JLipina/Kids_Mission_Control_Panel/Pictures/20230906_010632.jpg

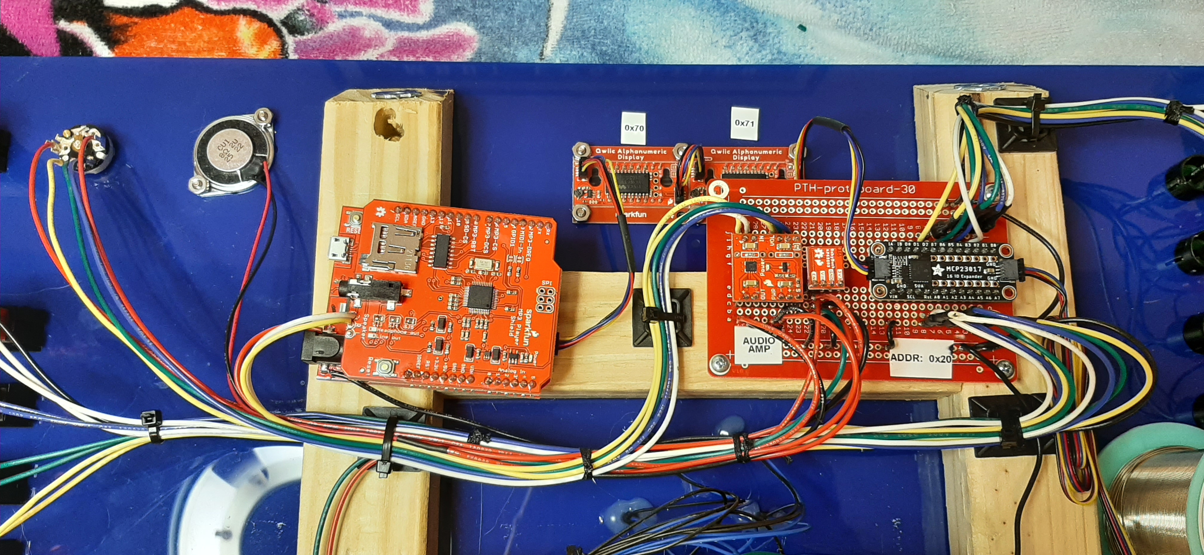
Pictures/20230906_010632.jpg
