JLipina/Kids_Mission_Control_Panel/Design Docs/Mission Control Panel Concept V1.PNG

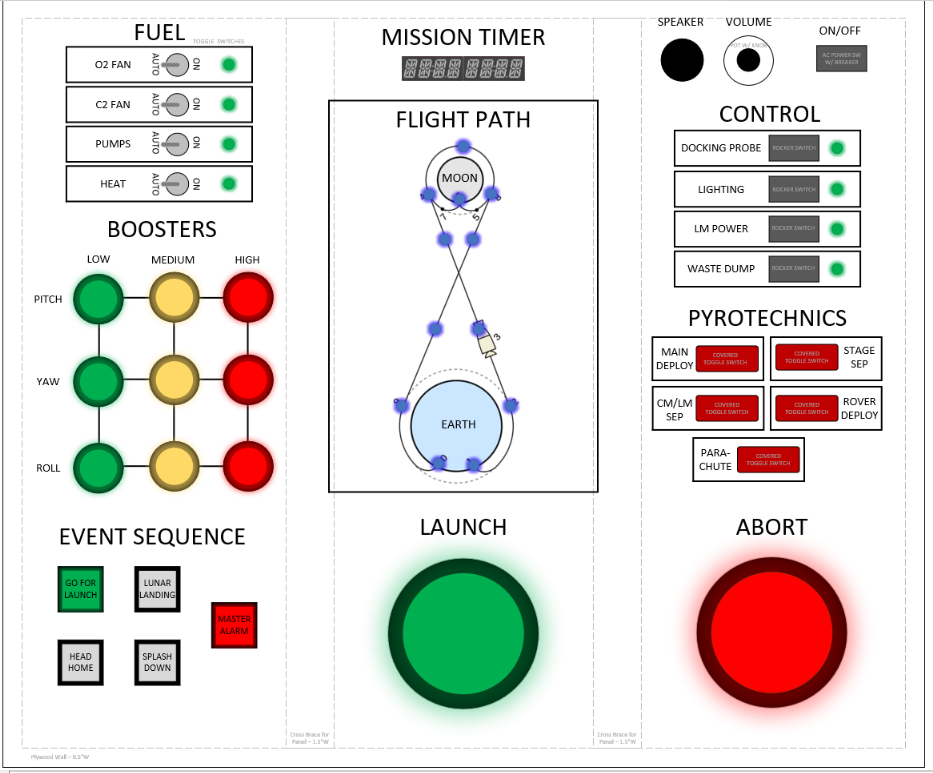
Design Docs/Mission Control Panel Concept V1.PNG
