JLipina/Kids_Mission_Control_Panel/Pictures/20230906_010615.jpg

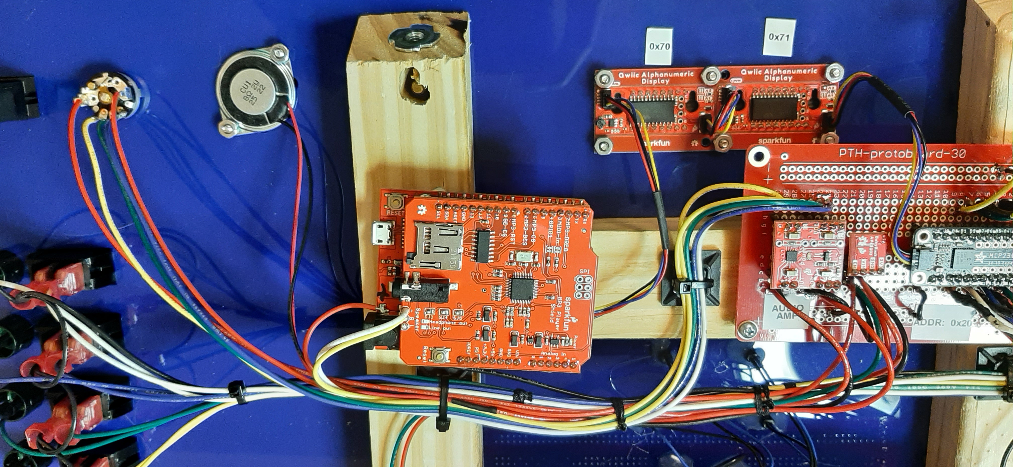
Pictures/20230906_010615.jpg
