JLipina/Kids_Mission_Control_Panel/Pictures/20230906_230627.jpg

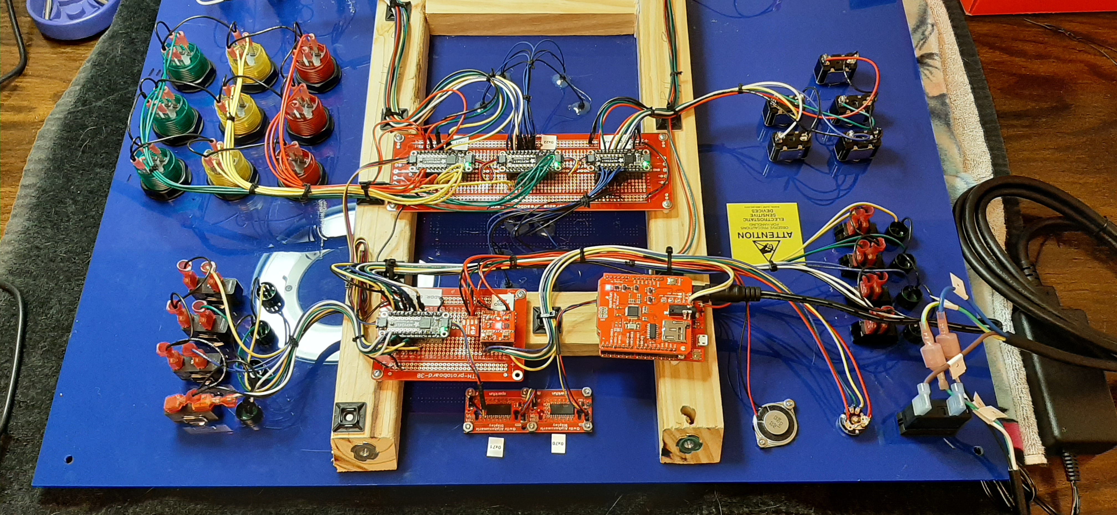
Pictures/20230906_230627.jpg
