JLipina/Kids_Mission_Control_Panel/Pictures/20230906_230656.jpg

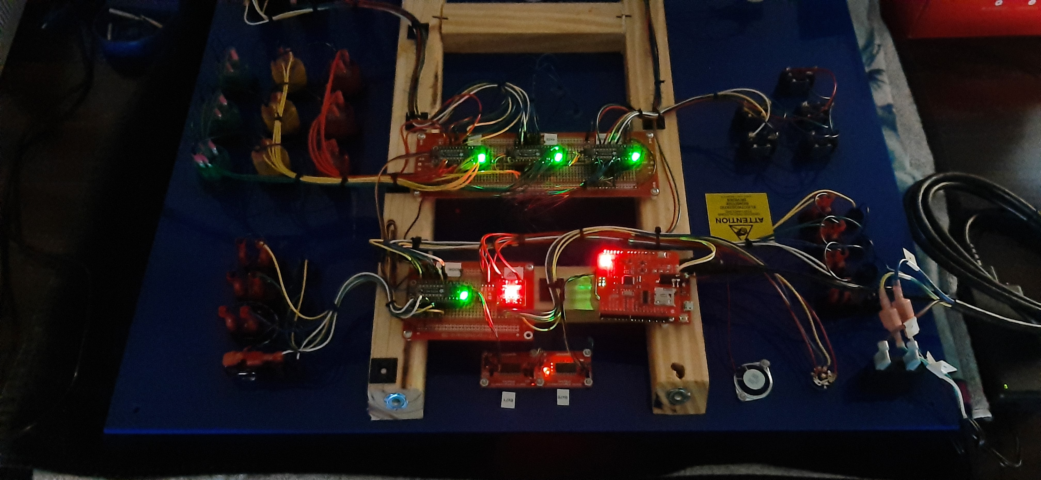
Pictures/20230906_230656.jpg
