JLipina/Kids_Mission_Control_Panel/Design Docs/Panel_BOM_6-10-23.xlsx

Description | MFG PN | Vendor PN | Vendor | QTY | Unit Cost | Line Total | Link | Notes
CORD 18AWG NEMA 5-15P TO CBL 6' | 211011-01 | Q941-ND | Digikey | 1 | $5.34 | $5.34 | https://www.digikey.com/en/products/detail/qualtek/211011-01/5639882 | AC wall plug to wires
Circular - 0.625" (15.88mm) Bushing 0.440" (11.18mm) Black | 2077 | 3720-2077-ND | Digikey | 10 | $0.11 | $1.12 | https://www.digikey.com/en/products/detail/heyco-products-corporation/2077/15906780 | For AC Cable passthough
TA36 CIRCUIT BREAKER 1P RO 5A | 3-128-200 | 486-3-128-200-ND | Digikey | 1 | $14.28 | $14.28 | https://www.digikey.com/en/products/detail/schurter-inc/3-128-200/14835864 | AC Power Switch with Breaker
CRD 18AWG IEC320-C13 - CBL 6.56' | 315005-01 | Q945-ND | Digikey | 1 | $6.51 | $6.51 | https://www.digikey.com/en/products/detail/qualtek/315005-01/1466536 | Internal AC switch to AC DC Converter Input
AC/DC DESKTOP ADAPTER 12V 36W | SDI36-12-U-P5 | 102-5154-ND | Digikey | 1 | $18.30 | $18.30 | https://www.digikey.com/en/products/detail/cui-inc/SDI36-12-U-P5/9817243 | AC DC converter for Arduino
SparkFun BabyBuck Regulator Breakout - 3.3V (AP63203) | COM-18357 | COM-18357 | Sparkfun | 1 | $4.50 | $4.50 | https://www.sparkfun.com/products/18357 | 3.3V Converter
SparkFun RedBoard Qwiic | DEV-15123 | DEV-15123 | Sparkfun | 1 | $21.50 | $21.50 | https://www.sparkfun.com/products/15123 | Microcontroller
SparkFun MP3 Player Shield | DEV-12660 | DEV-12660 | Sparkfun | 1 | $28.95 | $28.95 | https://www.sparkfun.com/products/12660 | Sound board
CONN HEADER VERT 20POS 2.54MM | 10129378-920001BLF | 10129378-920001BLF-ND | Digikey | 15 | $0.37 | $5.59 | https://www.digikey.com/en/products/detail/amphenol-cs-fci/10129378-920001BLF/7915969 | single row 0.1" Pitch Headers male
CONN HDR 13POS 0.1 TIN PCB | PPTC131LFBN-RC | S7011-ND | Digikey | 15 | $0.72 | $10.75 | https://www.digikey.com/en/products/detail/sullins-connector-solutions/PPTC131LFBN-RC/810151 | single row 0.1" Pitch Headers female
TPA2005D1 AUDIO AMP MONO 1.4W | BOB-11044 | 1568-1025-ND | Digikey | 1 | $9.50 | $9.50 | https://www.digikey.com/en/products/detail/sparkfun-electronics/BOB-11044/5140790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 | Speaker Amp
SPEAKER 8OHM 2W TOP PORT 99DB | CMS-28528N-L152 | 102-3841-ND | Digikey | 2 | $3.70 | $7.40 | https://www.digikey.com/en/products/detail/cui-devices/CMS-28528N-L152/6137734 | Speaker
microSD Card - 1GB (Class 4) | COM-15107 | COM-15107 | Sparkfun | 1 | $5.50 | $5.50 | https://www.sparkfun.com/products/15107 | microSD card
POT 10K OHM 1/20W PLASTIC LOG | P170SP1-FC15AR10K | 987-1739-ND | Digikey | 1 | $2.47 | $2.47 | https://www.digikey.com/en/products/detail/tt-electronics-bi/P170SP1-FC15AR10K/5957483 | Volume control pot
KNOB SMOOTH 0.236" PLASTIC | 1506 | 1722-1254-ND | Digikey | 2 | $3.23 | $6.46 | https://www.digikey.com/en/products/detail/davies-molding-llc/1506/6566477 | Volume Knob
Hook-Up Wire - Assortment (Stranded, 22 AWG) | PRT-11375 | PRT-11375 | Sparkfun | 1 | $22.50 | $22.50 | https://www.sparkfun.com/products/11375 | 22 awg wire kit
SparkFun Qwiic Alphanumeric Display - Red | COM-16916 | COM-16916 | Sparkfun | 2 | $9.95 | $19.90 | https://www.sparkfun.com/products/16916 | 7 seg display
STEMMA QT MCP23017 GPIO EXPAND | 5346 | 1528-5346-ND | Digikey | 4 | $5.95 | $23.80 | https://www.digikey.com/en/products/detail/adafruit-industries-llc/5346/15913270 | IO expanders
Qwiic Boost | SPX-17238 | SPX-17238 | Sparkfun | 1 | $3.95 | $3.95 | https://www.sparkfun.com/products/17238 | Qwiic level converter
Qwiic Cable - 50mm | PRT-14426 | PRT-14426 | Sparkfun | 4 | $0.95 | $3.80 | https://www.sparkfun.com/products/14426 | Qwiic Cable (50mm)
Qwiic Cable - 100mm | PRT-14427 | PRT-14427 | Sparkfun | 2 | $1.50 | $3.00 | https://www.sparkfun.com/products/14427 | Qwiic Cable (100mm)
Qwiic Cable - 500mm | PRT-14429 | PRT-14429 | Sparkfun | 1 | $1.95 | $1.95 | https://www.sparkfun.com/products/14429 | Qwiic Cable (500mm)
Qwiic JST Connector - SMD 4-Pin (Vertical) | PRT-16766 | PRT-16766 | Sparkfun | 7 | $0.55 | $3.85 | https://www.sparkfun.com/products/16766 | Qwiic Conn Vertical
SparkFun Solder-able Breadboard - Large | PRT-12699 | PRT-12699 | Sparkfun | 1 | $9.95 | $9.95 | https://www.sparkfun.com/products/12699 | proto soldering board large
SparkFun Solder-able Breadboard | PRT-12070 | PRT-12070 | Sparkfun | 3 | $5.50 | $16.50 | https://www.sparkfun.com/products/12070 | proto soldering board small
Big Dome Pushbutton - Green | COM-11275 | COM-11275 | Sparkfun | 1 | $12.95 | $12.95 | https://www.sparkfun.com/products/11275 | Green launch button
Big Dome Pushbutton - Red | COM-09181 | COM-09181 | Sparkfun | 1 | $12.95 | $12.95 | https://www.sparkfun.com/products/9181 | Red abort button
uxcell Game Push Button 34x34 Square 12V LED Illuminated Push Button Switch with Micro Switch for Arcade Video Games White 5pcs | ‎A19062000ux0446 | B07WQS69FQ | Amazon | 1 | $12.99 | $12.99 | https://www.amazon.com/dp/B07WQS69FQ/?coliid=INY0QTRAYR1CQ&colid=214XN6MOHGY0B | Square pushbutton set (5 buttons)
LED RED DIFFUSED 5MM ROUND T/H | MT4118-HR-A | 1125-1188-ND | Digikey | 15 | $0.19 | $2.83 | https://www.digikey.com/en/products/detail/marktech-optoelectronics/MT4118-HR-A/4214622 | square pushbutton LEDs (5mm red) | 5
LED GREEN DIFFUSED T-1 3/4 T/H | LTL-307G | LTL-307G | Digikey | 15 | $0.19 | $2.90 | https://www.digikey.com/en/products/detail/liteon/LTL-307G/669998 | square pushbutton LEDs (5mm green) | 8
SWITCH PUSH SPST-NO GRN 10MA 5V | 3487 | 1528-2321-ND | Digikey | 3 | $2.50 | $7.50 | https://www.digikey.com/en/products/detail/adafruit-industries-llc/3487/7364334 | Round arcade button (Green)
SWITCH PUSH SPST-NO YEL 10MA 5V | 3488 | 1528-2420-ND | Digikey | 3 | $2.50 | $7.50 | https://www.digikey.com/en/products/detail/adafruit-industries-llc/3488/7794999 | Round arcade button (Yellow)
SWITCH PUSH SPST-NO RED 10MA 5V | 3489 | 1528-2316-ND | Digikey | 3 | $2.50 | $7.50 | https://www.digikey.com/en/products/detail/adafruit-industries-llc/3489/7349495 | Round arcade button (Red)
CONN QC RCPT 18-22AWG 0.110 | 190190004 | WM18259-ND | Digikey | 45 | $0.23 | $10.35 | https://www.digikey.com/en/products/detail/molex/0190190004/279060 | Arcade button quick connects | 36
Nilight 90014E Heavy Duty Rocker Toggle Switch 12V 20A Red Cover SPST ON/Off 2Pin Car Truck Boat-5 Pack | 90014E | B07QKFD7Z7 | Amazon | 1 | $8.66 | $8.66 | https://www.amazon.com/dp/B07QKFD7Z7/?coliid=I2W1JWJY1F4WJ6&colid=214XN6MOHGY0B | Pyrotechnic toggle switches with covers set (5 switches)
Toggle Switch SPST Panel Mount | C3900BAAAA | 708-3058-ND | Digikey | 6 | $2.83 | $16.98 | https://www.digikey.com/en/products/detail/bulgin/C3900BAAAA/9598414 | Toggle switch (2pos)
SWITCH ROCKER SPST 16A 125V | GRS-2011-2015 | CWI456-ND | Digikey | 4 | $0.65 | $2.60 | https://www.digikey.com/en/products/detail/cw-industries/GRS-2011-2015/4425741 | Rocker switch (2pos)
CONN QC RCPT 18-22AWG 0.250 | 2-520263-2 | A27821CT-ND | Digikey | 30 | $0.32 | $9.63 | https://www.digikey.com/en/products/detail/te-connectivity-amp-connectors/2-520263-2/289251 | Rocker Switch, AC PWR SW, toggle switch, Quick Connects | 18
LED PANEL IND BLUE SNAP-IN 6" | 12-00003 | 839-12-00003-ND | Digikey | 15 | $1.94 | $29.14 | https://www.digikey.com/en/products/detail/tensility-international-corp/12-00003/17840391 | Small flush LED (FLIGHT PATH section) | 12
LED GREEN DIFFUSED 10MM T/H | WP813GD | 754-1898-ND | Digikey | 15 | $0.28 | $4.22 | https://www.digikey.com/en/products/detail/kingbright/WP813GD/3084264 | Large LEDs (10mm) | 8
LED HOLDER FOR 10MM LEDS | COM-11841 | 1568-1623-ND | Digikey | 10 | $0.55 | $5.50 | https://www.digikey.com/en/products/detail/sparkfun-electronics/COM-11841/7319613 | 10mm LED Holder (FUEL & CONTROL sections) | 8
RES 10K OHM 1% 1/4W AXIAL | RNF14FTD10K0 | RNF14FTD10K0CT-ND | Digikey | 100 | $0.04 | $3.54 | https://www.digikey.com/en/products/detail/stackpole-electronics-inc/RNF14FTD10K0/1706596 | Misc res (Pull down/ups) 10k
RES 1K OHM 5% 1/4W AXIAL | CF14JT1K00 | CF14JT1K00CT-ND | Digikey | 100 | $0.02 | $2.26 | https://www.digikey.com/en/products/detail/stackpole-electronics-inc/CF14JT1K00/1741314 | Misc res 1k
RES 120 OHM 5% 1/4W AXIAL | CF14JT120R | CF14JT120RCT-ND | Digikey | 100 | $0.02 | $2.26 | https://www.digikey.com/en/products/detail/stackpole-electronics-inc/CF14JT120R/1741278 | 5mm/10mm LED curr lim res
RES 30 OHM 5% 1/4W AXIAL | CF14JT30R0 | CF14JT30R0CT-ND | Digikey | 100 | $0.02 | $2.26 | https://www.digikey.com/en/products/detail/stackpole-electronics-inc/CF14JT30R0/1741389 | Flight path LED curr lim res
CBL TIE LOCKING BLK 18LBS 4.06" | 1-604771-0 | A112495-ND | Digikey | 50 | $0.13 | $6.42 | https://www.digikey.com/en/products/detail/te-connectivity-raychem-cable-protection/1-604771-0/2343016 | small zip ties
30 Sheets 8.5 x 11 Inch Clear Transparency Film 100% Transparent Sheets for Inkjet Printers Silk Screen Printing Overhead Projector Film | Clear Transparency Film | B08X2N82SX | Amazon | 1 | $6.99 | $6.99 | https://www.amazon.com/Transparency-Printers-Printing-Overhead-Projector/dp/B08X2N82SX | Transparency Film for Button Labels
ROUND SPACER #4 NYLON 1/4" | 9908-250 | 492-1074-ND | Digikey | 25 | $0.04 | $1.07 | https://www.digikey.com/en/products/detail/bivar-inc/9908-250/586394 | Board Spacer 0.25"
 |  |  |  |  |  | $0.00
 |  |  |  |  |  | $0.00
 |  |  |  |  |  | $0.00
 |  |  |  |  |  | $0.00
 |  |  |  |  |  | $0.00
 |  |  |  |  |  | $0.00
 |  | Total Estimated Cost |  |  |  | $310.03
NOTES: - Diagram of Flight Path for panel found at: https://en.wikipedia.org/wiki/Lunar_orbit_rendezvous - Much inspiration from Jeff Highsmith's build: https://makezine.com/article/home/furniture/making-fun-mission-control-desk/ - Another person's recreation: http://missioncontroldesk.blogspot.com/search?updated-max=2015-11-04T03:31:00-08:00&max-results=7 Digikey Cart: https://www.digikey.com/en/mylists/list/CSTQRVFLY5 Amazon Cart: https://www.amazon.com/hz/wishlist/ls/214XN6MOHGY0B?ref_=wl_share Sparkfun Cart: http://sfe.io/w171814
