JLipina/Kids_Mission_Control_Panel/Kids_Mission_Control_Panel.ino

/*
 * 
 */

#include <SPI.h>
#include <FreeStack.h>
#include <Adafruit_MCP23X17.h>

//Add the SdFat Libraries
#include <SdFat.h>

//and the MP3 Shield Library
#include <vs1053_SdFat.h>

/**
 * \brief Object instancing the SdFat library.
 *
 * principal object for handling all SdCard functions.
 */
SdFat sd;

/**
 * \brief Object instancing the vs1053 library.
 *
 * principal object for handling all the attributes, members and functions for the library.
 */
vs1053 MP3player;

const uint8_t VOLUME =  0; //0x0000 is maximum volume or 0db attenuation. Total silence is 0xFEFE

#include <Wire.h>
#include <SparkFun_Alphanumeric_Display.h>  //Click here to get the library: http://librarymanager/All#SparkFun_Qwiic_Alphanumeric_Display by SparkFun
HT16K33 display;

/**
 * \brief Object instancing the MCP23X17 library.
 *
 * principal object for handling all the attributes, members and functions for the library.
 */
Adafruit_MCP23X17 mcp1;
Adafruit_MCP23X17 mcp2;
Adafruit_MCP23X17 mcp3;
Adafruit_MCP23X17 mcp4;

#define O2_FAN_LED              8
#define O2_FAN_SW               9
#define C2_FAN_LED              10
#define C2_FAN_SW               11
#define PUMPS_LED               12
#define PUMPS_SW                13
#define HEAT_LED                14
#define HEAT_SW                 15
bool O2_FAN_Played =            FALSE;
bool C2_FAN_Played =            FALSE;
bool PUMPS_Played =             FALSE;
bool HEAT_Played =              FALSE;

#define DOCKING_LED             0
#define DOCKING_SW              1
#define LIGHTING_LED            2
#define LIGHTING_SW             3
#define LM_POWER_LED            4
#define LM_POWER_SW             5
#define WASTE_DUMP_LED          6
#define WASTE_DUMP_SW           7
bool DOCKING_Played =           FALSE;
bool LIGHTING_Played =          FALSE;
bool LM_POWER_Played =          FALSE;
bool WASTE_DUMP_Played =        FALSE;

#define PYRO_MAIN_SW            1
#define PYRO_STAGE_SW           0
#define PYRO_CM_LM_SW           3
#define PYRO_ROVER_SW           2
#define PYRO_PARACHUTE_SW       4
bool PYRO_MAIN_Played =         FALSE;
bool PYRO_STAGE_Played =        FALSE;
bool PYRO_CM_LM_Played =        FALSE;
bool PYRO_ROVER_Played =    FALSE;
bool PYRO_PARACHUTE_Played =    FALSE;

#define BOOSTER_LOW_PITCH_LED     14
#define BOOSTER_LOW_PITCH_SW      15
#define BOOSTER_LOW_YAW_LED       12
#define BOOSTER_LOW_YAW_SW        13
#define BOOSTER_LOW_ROLL_LED      10
#define BOOSTER_LOW_ROLL_SW       11
#define BOOSTER_MED_PITCH_LED     8
#define BOOSTER_MED_PITCH_SW      9
#define BOOSTER_MED_YAW_LED       14
#define BOOSTER_MED_YAW_SW        15
#define BOOSTER_MED_ROLL_LED      12
#define BOOSTER_MED_ROLL_SW       13
#define BOOSTER_HIGH_PITCH_LED    10
#define BOOSTER_HIGH_PITCH_SW     11
#define BOOSTER_HIGH_YAW_LED      8
#define BOOSTER_HIGH_YAW_SW       9
#define BOOSTER_HIGH_ROLL_LED     6
#define BOOSTER_HIGH_ROLL_SW      7
bool BOOSTER_LOW_PITCH_Played =   FALSE;
bool BOOSTER_LOW_YAW_Played =     FALSE;
bool BOOSTER_LOW_ROLL_Played =    FALSE;
bool BOOSTER_MED_PITCH_Played =   FALSE;
bool BOOSTER_MED_YAW_Played =     FALSE;
bool BOOSTER_MED_ROLL_Played =    FALSE;
bool BOOSTER_HIGH_PITCH_Played =  FALSE;
bool BOOSTER_HIGH_YAW_Played =    FALSE;
bool BOOSTER_HIGH_ROLL_Played =   FALSE;

#define GO_FOR_LAUNCH_LED         4
#define GO_FOR_LAUNCH_SW          5
#define LUNAR_LANDING_LED         6
#define LUNAR_LANDING_SW          7
#define HEAD_HOME_LED             0
#define HEAD_HOME_SW              1
#define SPLASHDOWN_LED            2
#define SPLASHDOWN_SW             3
#define MASTER_ALARM_LED          4
#define MASTER_ALARM_SW           5
#define GO_FOR_LAUNCH_LED_SPEED   300
unsigned long launchLedBlinkStart;
unsigned long launchLedBlinkCurr;
bool GO_LAUNCH_LED_State =        1;
bool GO_FOR_LAUNCH_Played =       FALSE;
bool LUNAR_LANDING_Played =       FALSE;
bool HEAD_HOME_Played =           FALSE;
bool SPLASHDOWN_Played =          FALSE;
bool MASTER_ALARM_Played =        FALSE;

#define LAUNCH_SW               5
#define ABORT_SW                6
bool LAUNCH_Played =            FALSE;
bool ABORT_Played =             FALSE;

#define PATH_LED_1              3
#define PATH_LED_2              2
#define PATH_LED_3              15
#define PATH_LED_4              10
#define PATH_LED_5              9
#define PATH_LED_6              8
#define PATH_LED_7              12
#define PATH_LED_8              13
#define PATH_LED_9              14
#define PATH_LED_10             11
#define PATH_LED_11             0
#define PATH_LED_12             1
#define PATH_SPEED              2000
int pathPosition =              1;
bool changePosition =           FALSE;

unsigned long startMillis;
unsigned long currentMillis;
unsigned long timerMillis;
uint8_t numTensMilliseconds = 0;
uint8_t numSingleSeconds = 0;
uint8_t numTensSeconds = 0;
uint8_t numSingleMinutes = 0;
uint8_t numTensMinutes = 0;
uint8_t numSingleHours = 0;
uint8_t numTensHours = 0;
char digit[10] = "0123456789";
char time[12] = "00:0000:00";

//------------------------------------------------------------------------------
/**
 * \brief Setup the Arduino Chip's feature for our use.
 *
 * After Arduino's kernel has booted initialize basic features for this
 * application, such as Serial port and MP3player objects with .begin.
 * Along with displaying the Help Menu.
 *
 * \note returned Error codes are typically passed up from MP3player.
 * Whicn in turns creates and initializes the SdCard objects.
 *
 * \see
 * \ref Error_Codes
 */
void setup() {

  uint8_t result; //result code from some function as to be tested at later time.

  Serial.begin(115200);

  Serial.print(F("F_CPU = "));
  Serial.println(F_CPU);
  Serial.print(F("Free RAM = ")); // available in Version 1.0 F() bases the string to into Flash, to use less SRAM.
  Serial.print(FreeStack(), DEC);  // FreeStack() is provided by SdFat
  Serial.println(F(" Should be a base line of 1028, on ATmega328 when using INTx"));

  //Initialize the SdCard.
  if(!sd.begin(SD_SEL, SPI_FULL_SPEED)) sd.initErrorHalt();
  // depending upon your SdCard environment, SPI_HAVE_SPEED may work better.
  if(!sd.chdir("/")) sd.errorHalt("sd.chdir");

  //Initialize the MP3 Player Shield
  result = MP3player.begin();
  //check result, see readme for error codes.
  if(result != 0) {
    Serial.print(F("Error code: "));
    Serial.print(result);
    Serial.println(F(" when trying to start MP3 player"));
    if( result == 6 ) {
      Serial.println(F("Warning: patch file not found, skipping.")); // can be removed for space, if needed.
      Serial.println(F("Use the \"d\" command to verify SdCard can be read")); // can be removed for space, if needed.
    }
  }

  MP3player.setVolume(VOLUME); //Set panel volume once since there's no method of adjusting in software while in normal use.

  Wire.begin(); //Display joins I2C bus
  display.begin(0x71, 0x70);
  //display.print("DYNETICS");
  display.colonOn();
  display.print(time);

  mcp1.begin_I2C(0X20);
  mcp2.begin_I2C(0X21);
  mcp3.begin_I2C(0X22);
  mcp4.begin_I2C(0X23);

// FUEL SWITCH/LED SETUPS
  mcp1.pinMode(O2_FAN_LED, OUTPUT);
  mcp1.pinMode(O2_FAN_SW, INPUT_PULLUP);
  mcp1.pinMode(C2_FAN_LED, OUTPUT);
  mcp1.pinMode(C2_FAN_SW, INPUT_PULLUP);
  mcp1.pinMode(PUMPS_LED, OUTPUT);
  mcp1.pinMode(PUMPS_SW, INPUT_PULLUP);
  mcp1.pinMode(HEAT_LED, OUTPUT);
  mcp1.pinMode(HEAT_SW, INPUT_PULLUP);
  mcp1.digitalWrite(O2_FAN_LED, LOW);
  mcp1.digitalWrite(C2_FAN_LED, LOW);
  mcp1.digitalWrite(PUMPS_LED, LOW);
  mcp1.digitalWrite(HEAT_LED, LOW);

// CONTROL SWITCH/LED SETUPS
  mcp1.pinMode(DOCKING_LED, OUTPUT);
  mcp1.pinMode(DOCKING_SW, INPUT_PULLUP);
  mcp1.pinMode(LIGHTING_LED, OUTPUT);
  mcp1.pinMode(LIGHTING_SW, INPUT_PULLUP);
  mcp1.pinMode(LM_POWER_LED, OUTPUT);
  mcp1.pinMode(LM_POWER_SW, INPUT_PULLUP);
  mcp1.pinMode(WASTE_DUMP_LED, OUTPUT);
  mcp1.pinMode(WASTE_DUMP_SW, INPUT_PULLUP);
  mcp1.digitalWrite(DOCKING_LED, LOW);
  mcp1.digitalWrite(LIGHTING_LED, LOW);
  mcp1.digitalWrite(LM_POWER_LED, LOW);
  mcp1.digitalWrite(WASTE_DUMP_LED, LOW);

// PYRO SWITCH SETUPS
  mcp4.pinMode(PYRO_MAIN_SW, INPUT_PULLUP);
  mcp4.pinMode(PYRO_STAGE_SW, INPUT_PULLUP);
  mcp4.pinMode(PYRO_CM_LM_SW, INPUT_PULLUP);
  mcp4.pinMode(PYRO_ROVER_SW, INPUT_PULLUP);
  mcp4.pinMode(PYRO_PARACHUTE_SW, INPUT_PULLUP);

// EVENT SEQUENCE SETUP
  mcp3.pinMode(GO_FOR_LAUNCH_LED, OUTPUT);
  mcp3.pinMode(GO_FOR_LAUNCH_SW, INPUT_PULLUP);
  mcp3.pinMode(LUNAR_LANDING_LED, OUTPUT);
  mcp3.pinMode(LUNAR_LANDING_SW, INPUT_PULLUP);
  mcp2.pinMode(HEAD_HOME_LED, OUTPUT);
  mcp2.pinMode(HEAD_HOME_SW, INPUT_PULLUP);
  mcp2.pinMode(SPLASHDOWN_LED, OUTPUT);
  mcp2.pinMode(SPLASHDOWN_SW, INPUT_PULLUP);
  mcp2.pinMode(MASTER_ALARM_LED, OUTPUT);
  mcp2.pinMode(MASTER_ALARM_SW, INPUT_PULLUP);
  mcp3.digitalWrite(GO_FOR_LAUNCH_LED, HIGH);
  mcp3.digitalWrite(LUNAR_LANDING_LED, HIGH);
  mcp2.digitalWrite(HEAD_HOME_LED, HIGH);
  mcp2.digitalWrite(SPLASHDOWN_LED, HIGH);
  mcp2.digitalWrite(MASTER_ALARM_LED, LOW);

// LAUNCH & ABORT SWITCH SETUPS
  mcp4.pinMode(LAUNCH_SW, INPUT_PULLUP);
  mcp4.pinMode(ABORT_SW, INPUT_PULLUP);

// BOOSTER BUTTON/LED SETUPS
  mcp3.pinMode(BOOSTER_LOW_PITCH_LED, OUTPUT);
  mcp3.pinMode(BOOSTER_LOW_PITCH_SW, INPUT_PULLUP);
  mcp3.pinMode(BOOSTER_LOW_YAW_LED, OUTPUT);
  mcp3.pinMode(BOOSTER_LOW_YAW_SW, INPUT_PULLUP);
  mcp3.pinMode(BOOSTER_LOW_ROLL_LED, OUTPUT);
  mcp3.pinMode(BOOSTER_LOW_ROLL_SW, INPUT_PULLUP);
  mcp3.pinMode(BOOSTER_MED_PITCH_LED, OUTPUT);
  mcp3.pinMode(BOOSTER_MED_PITCH_SW, INPUT_PULLUP);
  mcp2.pinMode(BOOSTER_MED_YAW_LED, OUTPUT);
  mcp2.pinMode(BOOSTER_MED_YAW_SW, INPUT_PULLUP);
  mcp2.pinMode(BOOSTER_MED_ROLL_LED, OUTPUT);
  mcp2.pinMode(BOOSTER_MED_ROLL_SW, INPUT_PULLUP);
  mcp2.pinMode(BOOSTER_HIGH_PITCH_LED, OUTPUT);
  mcp2.pinMode(BOOSTER_HIGH_PITCH_SW, INPUT_PULLUP);
  mcp2.pinMode(BOOSTER_HIGH_YAW_LED, OUTPUT);
  mcp2.pinMode(BOOSTER_HIGH_YAW_SW, INPUT_PULLUP);
  mcp2.pinMode(BOOSTER_HIGH_ROLL_LED, OUTPUT);
  mcp2.pinMode(BOOSTER_HIGH_ROLL_SW, INPUT_PULLUP);
  mcp3.digitalWrite(BOOSTER_LOW_PITCH_LED, HIGH);
  mcp3.digitalWrite(BOOSTER_LOW_YAW_LED, HIGH);
  mcp3.digitalWrite(BOOSTER_LOW_ROLL_LED, HIGH);
  mcp3.digitalWrite(BOOSTER_MED_PITCH_LED, HIGH);
  mcp2.digitalWrite(BOOSTER_MED_YAW_LED, HIGH);
  mcp2.digitalWrite(BOOSTER_MED_ROLL_LED, HIGH);
  mcp2.digitalWrite(BOOSTER_HIGH_PITCH_LED, HIGH);
  mcp2.digitalWrite(BOOSTER_HIGH_YAW_LED, HIGH);
  mcp2.digitalWrite(BOOSTER_HIGH_ROLL_LED, HIGH);

// FLIGHT PATH LED SETUPS
  mcp3.pinMode(PATH_LED_1, OUTPUT);
  mcp3.pinMode(PATH_LED_2, OUTPUT);
  mcp4.pinMode(PATH_LED_3, OUTPUT);
  mcp4.pinMode(PATH_LED_4, OUTPUT);
  mcp4.pinMode(PATH_LED_5, OUTPUT);
  mcp4.pinMode(PATH_LED_6, OUTPUT);
  mcp4.pinMode(PATH_LED_7, OUTPUT);
  mcp4.pinMode(PATH_LED_8, OUTPUT);
  mcp4.pinMode(PATH_LED_9, OUTPUT);
  mcp4.pinMode(PATH_LED_10, OUTPUT);
  mcp3.pinMode(PATH_LED_11, OUTPUT);
  mcp3.pinMode(PATH_LED_12, OUTPUT);
  mcp3.digitalWrite(PATH_LED_1, HIGH);
  mcp3.digitalWrite(PATH_LED_2, LOW);
  mcp4.digitalWrite(PATH_LED_3, LOW);
  mcp4.digitalWrite(PATH_LED_4, LOW);
  mcp4.digitalWrite(PATH_LED_5, LOW);
  mcp4.digitalWrite(PATH_LED_6, LOW);
  mcp4.digitalWrite(PATH_LED_7, LOW);
  mcp4.digitalWrite(PATH_LED_8, LOW);
  mcp4.digitalWrite(PATH_LED_9, LOW);
  mcp4.digitalWrite(PATH_LED_10, LOW);
  mcp3.digitalWrite(PATH_LED_11, LOW);
  mcp3.digitalWrite(PATH_LED_12, LOW);

  startMillis = millis();
  launchLedBlinkStart = millis();
  timerMillis = millis();

}

//------------------------------------------------------------------------------

void loop() {

// FUEL SWITCHES ~~~~~~~~~~~~~~~~~~~~~~~~~~~~~~~~~~~~~~~~~~~~~~~~~~~~~~~~~~~~~~~~~~~~~~~~~~~~~~~~~~~~~~~~~~~~  

  O2_FAN_Played = checkSwitchMCP1NormallyOffLED(O2_FAN_SW, O2_FAN_LED, O2_FAN_Played, "o2_fan01.mp3");
  C2_FAN_Played = checkSwitchMCP1NormallyOffLED(C2_FAN_SW, C2_FAN_LED, C2_FAN_Played, "c2_fan01.mp3");
  PUMPS_Played = checkSwitchMCP1NormallyOffLED(PUMPS_SW, PUMPS_LED, PUMPS_Played, "pump0002.mp3");
  HEAT_Played = checkSwitchMCP1NormallyOffLED(HEAT_SW, HEAT_LED, HEAT_Played, "heat0001.mp3");

// CONTROL SWITCHES ~~~~~~~~~~~~~~~~~~~~~~~~~~~~~~~~~~~~~~~~~~~~~~~~~~~~~~~~~~~~~~~~~~~~~~~~~~~~~~~~~~~~~~~~~~~~ 

  DOCKING_Played = checkSwitchMCP1NormallyOffLED(DOCKING_SW, DOCKING_LED, DOCKING_Played, "dk_probe.mp3");
  LIGHTING_Played = checkSwitchMCP1NormallyOffLED(LIGHTING_SW, LIGHTING_LED, LIGHTING_Played, "lighting.mp3");
  LM_POWER_Played = checkSwitchMCP1NormallyOffLED(LM_POWER_SW, LM_POWER_LED, LM_POWER_Played, "lm_power.mp3");
  WASTE_DUMP_Played = checkSwitchMCP1NormallyOffLED(WASTE_DUMP_SW, WASTE_DUMP_LED, WASTE_DUMP_Played, "waste_dp.mp3");

// PYROTECHNIC SWITCHES ~~~~~~~~~~~~~~~~~~~~~~~~~~~~~~~~~~~~~~~~~~~~~~~~~~~~~~~~~~~~~~~~~~~~~~~~~~~~~~~~~~~~~~~~~~~~
  
  PYRO_MAIN_Played = checkSwitchNoLED(PYRO_MAIN_SW, PYRO_MAIN_Played, "main_dpy.mp3");
  PYRO_STAGE_Played = checkSwitchNoLED(PYRO_STAGE_SW, PYRO_STAGE_Played, "stag_sep.mp3");
  PYRO_CM_LM_Played = checkSwitchNoLED(PYRO_CM_LM_SW, PYRO_CM_LM_Played, "cmlm_sep.mp3");
  PYRO_ROVER_Played = checkSwitchNoLED(PYRO_ROVER_SW, PYRO_ROVER_Played, "rove_dpy.mp3");
  PYRO_PARACHUTE_Played = checkSwitchNoLED(PYRO_PARACHUTE_SW, PYRO_PARACHUTE_Played, "parachut.mp3");

// LAUNCH & ABORT BUTTONS ~~~~~~~~~~~~~~~~~~~~~~~~~~~~~~~~~~~~~~~~~~~~~~~~~~~~~~~~~~~~~~~~~~~~~~~~~~~~~~~~~~~~~~~~~~~~

  LAUNCH_Played = checkSwitchNoLED(LAUNCH_SW, LAUNCH_Played, "launch01.mp3");
  ABORT_Played = checkSwitchNoLED(ABORT_SW, ABORT_Played, "abort001.mp3");

// EVENT SEQUENCE BUTTONS ~~~~~~~~~~~~~~~~~~~~~~~~~~~~~~~~~~~~~~~~~~~~~~~~~~~~~~~~~~~~~~~~~~~~~~~~~~~~~~~~~~~~~~~~~~~~  

  GO_FOR_LAUNCH_Played = checkSwitchGoForLaunch(GO_FOR_LAUNCH_SW, GO_FOR_LAUNCH_LED, GO_FOR_LAUNCH_Played, "g4launch.mp3");
  LUNAR_LANDING_Played = checkSwitchMCP3NormallyOnLED(LUNAR_LANDING_SW, LUNAR_LANDING_LED, LUNAR_LANDING_Played, "lunaland.mp3");
  HEAD_HOME_Played = checkSwitchMCP2NormallyOnLED(HEAD_HOME_SW, HEAD_HOME_LED, HEAD_HOME_Played, "hed_home.mp3");
  SPLASHDOWN_Played = checkSwitchMCP2NormallyOnLED(SPLASHDOWN_SW, SPLASHDOWN_LED, SPLASHDOWN_Played, "spalshdn.mp3");
  MASTER_ALARM_Played = checkSwitchMCP2NormallyOffLED(MASTER_ALARM_SW, MASTER_ALARM_LED, MASTER_ALARM_Played, "mstr_alm.mp3");

// BOOSTER BUTTONS ~~~~~~~~~~~~~~~~~~~~~~~~~~~~~~~~~~~~~~~~~~~~~~~~~~~~~~~~~~~~~~~~~~~~~~~~~~~~~~~~~~~~~~~~~~~~

  BOOSTER_LOW_PITCH_Played = checkSwitchMCP3NormallyOnLED(BOOSTER_LOW_PITCH_SW, BOOSTER_LOW_PITCH_LED, BOOSTER_LOW_PITCH_Played, "bost_p_l.mp3");
  BOOSTER_LOW_YAW_Played = checkSwitchMCP3NormallyOnLED(BOOSTER_LOW_YAW_SW, BOOSTER_LOW_YAW_LED, BOOSTER_LOW_YAW_Played, "bost_y_l.mp3");
  BOOSTER_LOW_ROLL_Played = checkSwitchMCP3NormallyOnLED(BOOSTER_LOW_ROLL_SW, BOOSTER_LOW_ROLL_LED, BOOSTER_LOW_ROLL_Played, "bost_r_l.mp3");
  BOOSTER_MED_PITCH_Played = checkSwitchMCP3NormallyOnLED(BOOSTER_MED_PITCH_SW, BOOSTER_MED_PITCH_LED, BOOSTER_MED_PITCH_Played, "bost_p_m.mp3");
  BOOSTER_MED_YAW_Played = checkSwitchMCP2NormallyOnLED(BOOSTER_MED_YAW_SW, BOOSTER_MED_YAW_LED, BOOSTER_MED_YAW_Played, "bost_y_m.mp3");
  BOOSTER_MED_ROLL_Played = checkSwitchMCP2NormallyOnLED(BOOSTER_MED_ROLL_SW, BOOSTER_MED_ROLL_LED, BOOSTER_MED_ROLL_Played, "bost_r_m.mp3");
  BOOSTER_HIGH_PITCH_Played = checkSwitchMCP2NormallyOnLED(BOOSTER_HIGH_PITCH_SW, BOOSTER_HIGH_PITCH_LED, BOOSTER_HIGH_PITCH_Played, "bost_p_h.mp3");
  BOOSTER_HIGH_YAW_Played = checkSwitchMCP2NormallyOnLED(BOOSTER_HIGH_YAW_SW, BOOSTER_HIGH_YAW_LED, BOOSTER_HIGH_YAW_Played, "bost_y_h.mp3");
  BOOSTER_HIGH_ROLL_Played = checkSwitchMCP2NormallyOnLED(BOOSTER_HIGH_ROLL_SW, BOOSTER_HIGH_ROLL_LED, BOOSTER_HIGH_ROLL_Played, "bost_r_h.mp3");

// FLIGHT PATH LEDS ~~~~~~~~~~~~~~~~~~~~~~~~~~~~~~~~~~~~~~~~~~~~~~~~~~~~~~~~~~~~~~~~~~~~~~~~~


  currentMillis = millis();
  if(currentMillis - startMillis >= PATH_SPEED){
    changePosition = TRUE;
    pathPosition++;
    if(pathPosition >= 13){
      pathPosition = 1;
    }
    startMillis = millis();
  }

  if(changePosition == TRUE){
    if(pathPosition == 1){
      mcp3.digitalWrite(PATH_LED_12, LOW);
      mcp3.digitalWrite(PATH_LED_1, HIGH);
      changePosition = FALSE;
    }
    else if(pathPosition == 2){
      mcp3.digitalWrite(PATH_LED_1, LOW);
      mcp3.digitalWrite(PATH_LED_2, HIGH);
      changePosition = FALSE;
    }
    else if(pathPosition == 3){
      mcp3.digitalWrite(PATH_LED_2, LOW);
      mcp4.digitalWrite(PATH_LED_3, HIGH);
      changePosition = FALSE;
    }
    else if(pathPosition == 4){
      mcp4.digitalWrite(PATH_LED_3, LOW);
      mcp4.digitalWrite(PATH_LED_4, HIGH);
      changePosition = FALSE;
    }
    else if(pathPosition == 5){
      mcp4.digitalWrite(PATH_LED_4, LOW);
      mcp4.digitalWrite(PATH_LED_5, HIGH);
      changePosition = FALSE;
    }
    else if(pathPosition == 6){
      mcp4.digitalWrite(PATH_LED_5, LOW);
      mcp4.digitalWrite(PATH_LED_6, HIGH);
      changePosition = FALSE;
    }
    else if(pathPosition == 7){
      mcp4.digitalWrite(PATH_LED_6, LOW);
      mcp4.digitalWrite(PATH_LED_7, HIGH);
      changePosition = FALSE;
    }
    else if(pathPosition == 8){
      mcp4.digitalWrite(PATH_LED_7, LOW);
      mcp4.digitalWrite(PATH_LED_8, HIGH);
      changePosition = FALSE;
    }
    else if(pathPosition == 9){
      mcp4.digitalWrite(PATH_LED_8, LOW);
      mcp4.digitalWrite(PATH_LED_9, HIGH);
      changePosition = FALSE;
    }
    else if(pathPosition == 10){
      mcp4.digitalWrite(PATH_LED_9, LOW);
      mcp4.digitalWrite(PATH_LED_10, HIGH);
      changePosition = FALSE;
    }
    else if(pathPosition == 11){
      mcp4.digitalWrite(PATH_LED_10, LOW);
      mcp3.digitalWrite(PATH_LED_11, HIGH);
      changePosition = FALSE;
    }
    else if(pathPosition == 12){
      mcp3.digitalWrite(PATH_LED_11, LOW);
      mcp3.digitalWrite(PATH_LED_12, HIGH);
      changePosition = FALSE;
    }
  }
  
// Mission Control Timer ~~~~~~~~~~~~~~~~~~~~~~~~~~~~~~~~~~~~~~~~~~~~~~~~~~~~~~~~~~~~~~~~~~~~~~~~~~~~~~~~~~~~~~~~~~~~~~~~~~~~~~

  if(currentMillis - timerMillis >= 100){
    numTensMilliseconds ++;
    if(numTensMilliseconds >= 10){
      numTensMilliseconds = 0;
      numSingleSeconds ++;
      if(numSingleSeconds >= 10){
        numSingleSeconds = 0;
        numTensSeconds ++;
        if(numTensSeconds >= 7){
          numTensSeconds = 0;
          numSingleMinutes ++;
          if(numSingleMinutes >= 10){
            numSingleMinutes = 0;
            numTensMinutes ++;
            if(numTensMinutes >= 7){
              numTensMinutes = 0;
              numSingleHours ++;
              if(numSingleHours >= 10){
                numSingleHours = 0;
                numTensHours ++;
                if(numTensHours >= 10){
                  numTensHours = 0;
                }
                //display.printChar(digit[numTensHours], 0);
                time[0] = digit[numTensHours];
              }
              //display.printChar(digit[numSingleHours], 1);
              time[1] = digit[numSingleHours];
            }
            //display.printChar(digit[numTensMinutes], 2);
            time[3] = digit[numTensMinutes];
          }
          //display.printChar(digit[numSingleMinutes], 3);
          time[4] = digit[numSingleMinutes];
        }
        //display.printChar(digit[numTensSeconds], 4);
        time[5] = digit[numTensSeconds];
      }
      //display.printChar(digit[numSingleSeconds], 5);
      time[6] = digit[numSingleSeconds];
      //display.print(time);
    }
    timerMillis = millis();
    //display.printChar(digit[numTensMilliseconds], 6);
    time[8] = digit[numTensMilliseconds];
    display.print(time);
  }

}

// Functions ~~~~~~~~~~~~~~~~~~~~~~~~~~~~~~~~~~~~~~~~~~~~~~~~~~~~~~~~~~~~~~~~~~~~~~~~~~~~~~~~~~~~~~~~~~~~~~~~~~~~

bool checkSwitchMCP1NormallyOffLED(int switchName, int LEDName, bool playedState, char* audioFileName) {
  if(!mcp1.digitalRead(switchName) && playedState == FALSE){
    mcp1.digitalWrite(LEDName, HIGH);
    MP3player.playMP3(audioFileName);
    playedState = TRUE;
    Serial.print(audioFileName);
    Serial.println(F(" ON"));
  } 
  if(mcp1.digitalRead(switchName) && playedState == TRUE){
    mcp1.digitalWrite(LEDName, LOW);
    playedState = FALSE;
    Serial.print(audioFileName);
    Serial.println(F(" OFF"));
  }
  return playedState;
}

bool checkSwitchMCP2NormallyOffLED(int switchName, int LEDName, bool playedState, char* audioFileName) {
  if(!mcp2.digitalRead(switchName) && playedState == FALSE){
    mcp2.digitalWrite(LEDName, HIGH);
    MP3player.playMP3(audioFileName);
    playedState = TRUE;
    Serial.print(audioFileName);
    Serial.println(F(" ON"));
  } 
  if(mcp2.digitalRead(switchName) && playedState == TRUE){
    mcp2.digitalWrite(LEDName, LOW);
    playedState = FALSE;
    Serial.print(audioFileName);
    Serial.println(F(" OFF"));
  }
  return playedState;
}

bool checkSwitchMCP2NormallyOnLED(int switchName, int LEDName, bool playedState, char* audioFileName) {
  if(!mcp2.digitalRead(switchName) && playedState == FALSE){
    mcp2.digitalWrite(LEDName, LOW);
    MP3player.playMP3(audioFileName);
    playedState = TRUE;
    Serial.print(audioFileName);
    Serial.println(F(" ON"));
  } 
  if(mcp2.digitalRead(switchName) && playedState == TRUE){
    mcp2.digitalWrite(LEDName, HIGH);
    playedState = FALSE;
    Serial.print(audioFileName);
    Serial.println(F(" OFF"));
  }
  return playedState;
}

bool checkSwitchMCP3NormallyOnLED(int switchName, int LEDName, bool playedState, char* audioFileName) {
  if(!mcp3.digitalRead(switchName) && playedState == FALSE){
    mcp3.digitalWrite(LEDName, LOW);
    MP3player.playMP3(audioFileName);
    playedState = TRUE;
    Serial.print(audioFileName);
    Serial.println(F(" ON"));
  } 
  if(mcp3.digitalRead(switchName) && playedState == TRUE){
    mcp3.digitalWrite(LEDName, HIGH);
    playedState = FALSE;
    Serial.print(audioFileName);
    Serial.println(F(" OFF"));
  }
  return playedState;
}

bool checkSwitchNoLED(int switchName, bool playedState, char* audioFileName) {
  if(!mcp4.digitalRead(switchName) && playedState == FALSE){
    MP3player.playMP3(audioFileName);
    playedState = TRUE;
    Serial.print(audioFileName);
    Serial.println(F(" ON"));
  } 
  if(mcp4.digitalRead(switchName) && playedState == TRUE){
    playedState = FALSE;
    Serial.print(audioFileName);
    Serial.println(F(" OFF"));
  }
  return playedState;
}

bool checkSwitchGoForLaunch(int switchName, int LEDName, bool playedState, char* audioFileName) {
  if(!mcp3.digitalRead(switchName) && playedState == FALSE){
    MP3player.playMP3(audioFileName);
    playedState = TRUE;
    Serial.print(audioFileName);
    Serial.println(F(" ON"));
  } 
  if(mcp3.digitalRead(switchName) && playedState == TRUE){
    playedState = FALSE;
    Serial.print(audioFileName);
    Serial.println(F(" OFF"));
  }

  launchLedBlinkCurr = millis();
    if(launchLedBlinkCurr - launchLedBlinkStart >= GO_FOR_LAUNCH_LED_SPEED){
      GO_LAUNCH_LED_State = !GO_LAUNCH_LED_State;
      mcp3.digitalWrite(GO_FOR_LAUNCH_LED, GO_LAUNCH_LED_State);
      launchLedBlinkStart = millis();
    }
  return playedState;
}
