JLipina/Kids_Mission_Control_Panel/(commit log)

2023-10-14 Initial Document Upload
    Uploaded design files, a folder for audio files, pictures, and the minimally viable Arduino code.
    [Panel_BOM_6-10-23.xlsx]
2023-10-15 Completed Panel Functionality
    Changed ino name to match repo folder name; Changed audio file names to 8 character names as required by the mp3 player library; Adjusted and added new audio files for remaining switches; Put switch and LED control into functions and call those functions in loop() to make it easier to follow, update, and take up less storage; Added functionality for rest of panel, pyro, control, and launch/abort buttons.
2023-10-19 Adjusted Audio & Added Mission Timer
    Mission Time functionality added to count up the time since turn-on on the 2 alphanumeric displays. Also adjusted volume levels of audio files to bring up the quiet ones.
